dimitri-rebrikov/CbRadioRotaryChannelSelector/kicad/handheld_microphone_vx-2412.sch

## KiCad design kicad/handheld_microphone_vx-2412.sch (2023-02-03)

Schematic: handheld_microphone_vx-2412.sch

Parts:
Channel_DOWN: SW_Push
Channel_UP: SW_Push
PTT: SW_Push
