dimitri-rebrikov/CbRadioRotaryChannelSelector/kicad/rotary_decoder.sch

## KiCad design kicad/rotary_decoder.sch (2023-01-29)

Schematic: rotary_decoder.sch

Parts:
C1, C3, C5, C6, C8: 100n
C2, C4: 10n
C7: 47u
D1, D2: LED
D3, D4: 1N4148; D_DO-35_SOD27_P7.62mm_Horizontal
K1, K2: TR5V-M-12V
P1: Channel Up
P2: Channel Down
Q1, Q2: BC327; TO-92_Inline
R1, R4, R5: 10k
R2, R3: 100k
R6, R8: 200k
R7, R9: 500k
R10, R11: 2k
R12, R13: 470
SW1: ELV60LS
U1: CD4013B
U2: CD4011B
U3, U4: NE555P
