dimitri-rebrikov/CbRadioRotaryChannelSelector/(commit log)

2023-01-16 initial commit of the rotary decoder schematics
    [rotary_decoder.sch]
2023-01-16 minor adjustments
    [rotary_decoder.sch]
2023-01-22 finished schematics
    [rotary_decoder.sch]
2023-01-29 added power flag to fix the Elecrical Rule Checker warning
    [rotary_decoder.sch]
2023-01-29 small rearrangement
    [rotary_decoder.sch]
2023-01-29 added Circuit Diagram Explanation
2023-01-29 fixed the link ot the circuit diagram
2023-02-03 added Connecting and Tuning chapters
    [handheld_microphone_vx-2412.sch]
